Allen-Synthesis/USB-Router/(notices)

Notices in the files:
kicad/usb-router.kicad_pcb:
www.allensynthesis.co.uk CERN OHL-S
